zufari4/RadioChat/Docs/Used pins.txt

Pin number = GPIO_N - where N is pin number

[ Flash ]

miso = 19
mosi = 23
sck  = 18
cs   = 5

[ Display ]

RS  = 2
R_W = 15
E   = 4
BLA = 17

[ Led ]

ON = 21

[ Buzzier ]

IO = 22

[ Keyboard ]

SH_LD = 16
QH    = 13
CLK   = 14

[ Radio ]

AUX = 32
M0  = 27
M1  = 26
RX  = 25
TX  = 33

[Battery]

ADC = 35
