zufari4/RadioChat/Docs/esp32-devkitC-v4-pinout.png

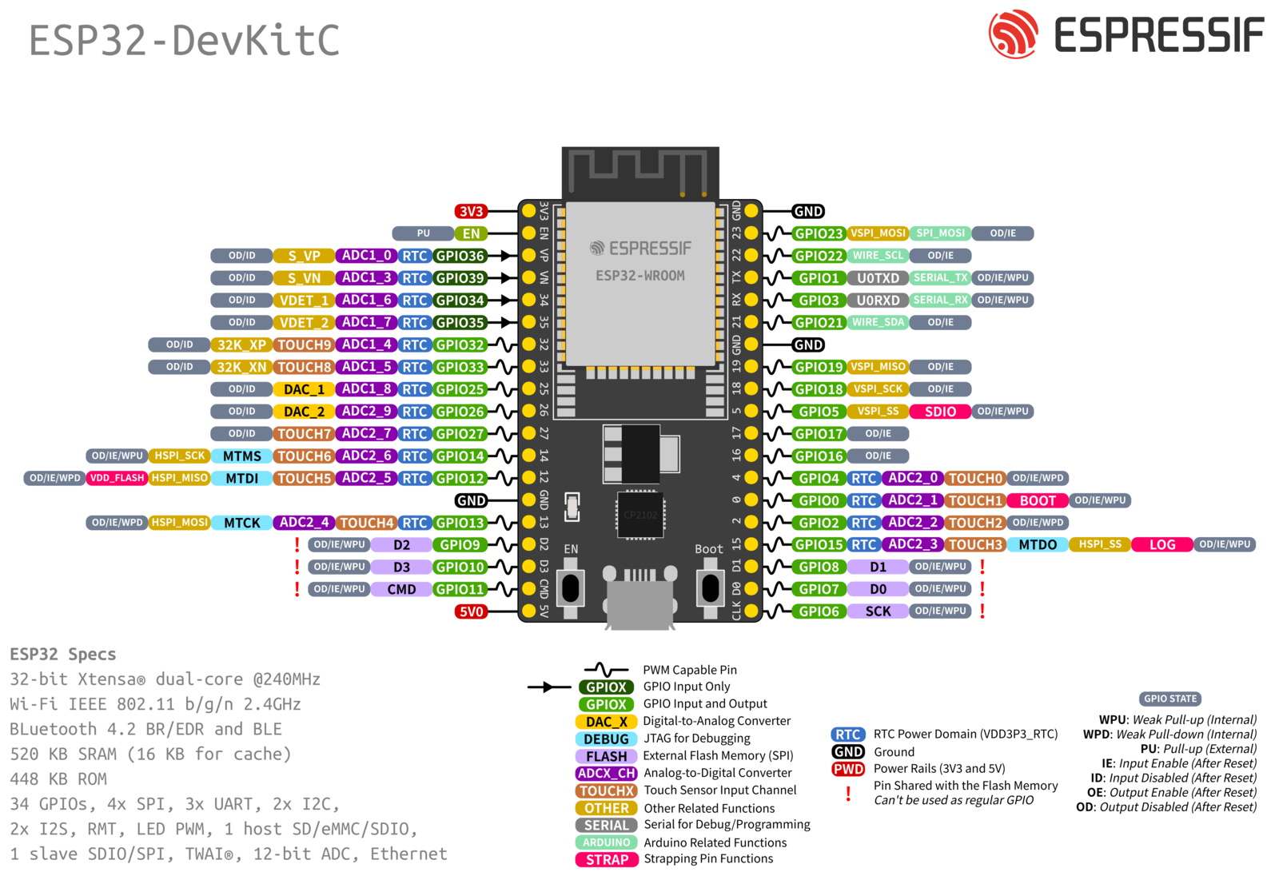
Docs/esp32-devkitC-v4-pinout.png
