zufari4/RadioChat/Docs/main plate lut.pdf

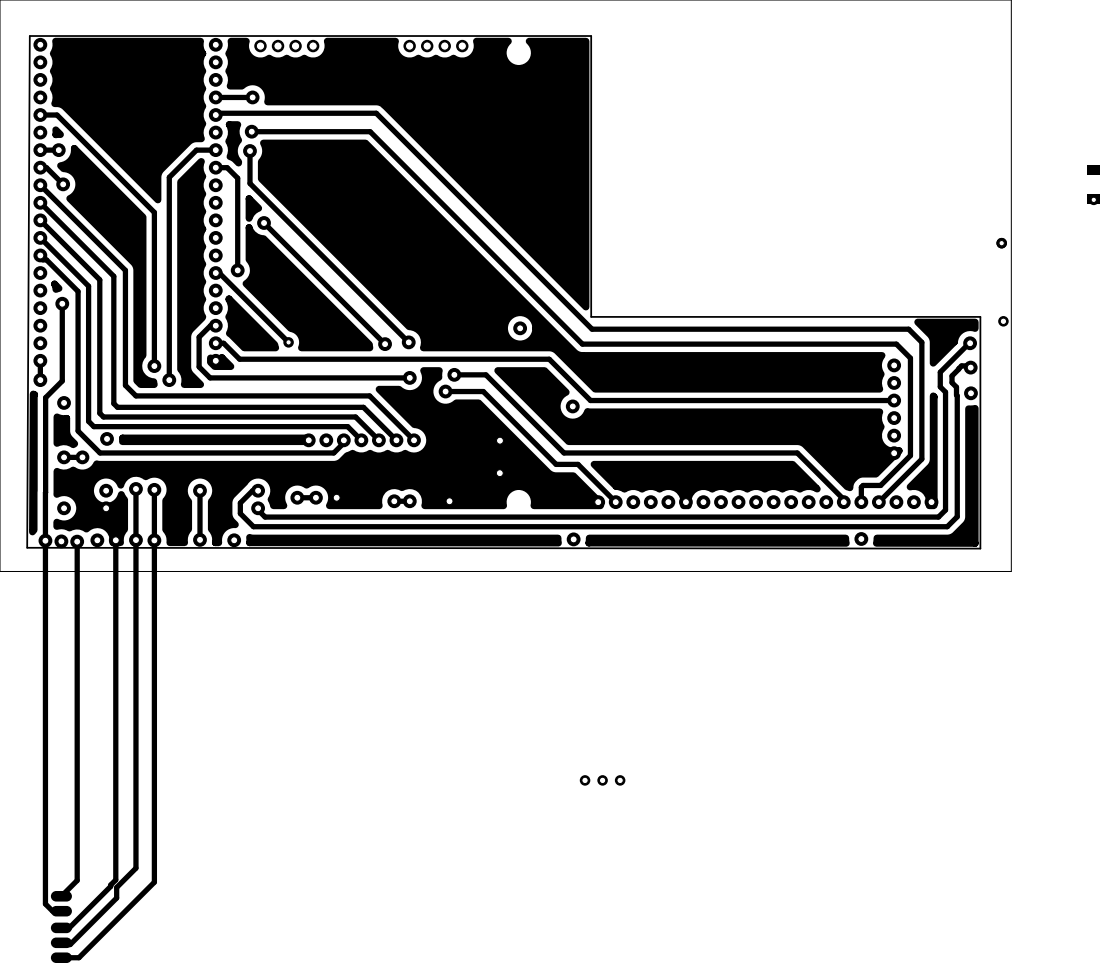
[picture p3: page 1]

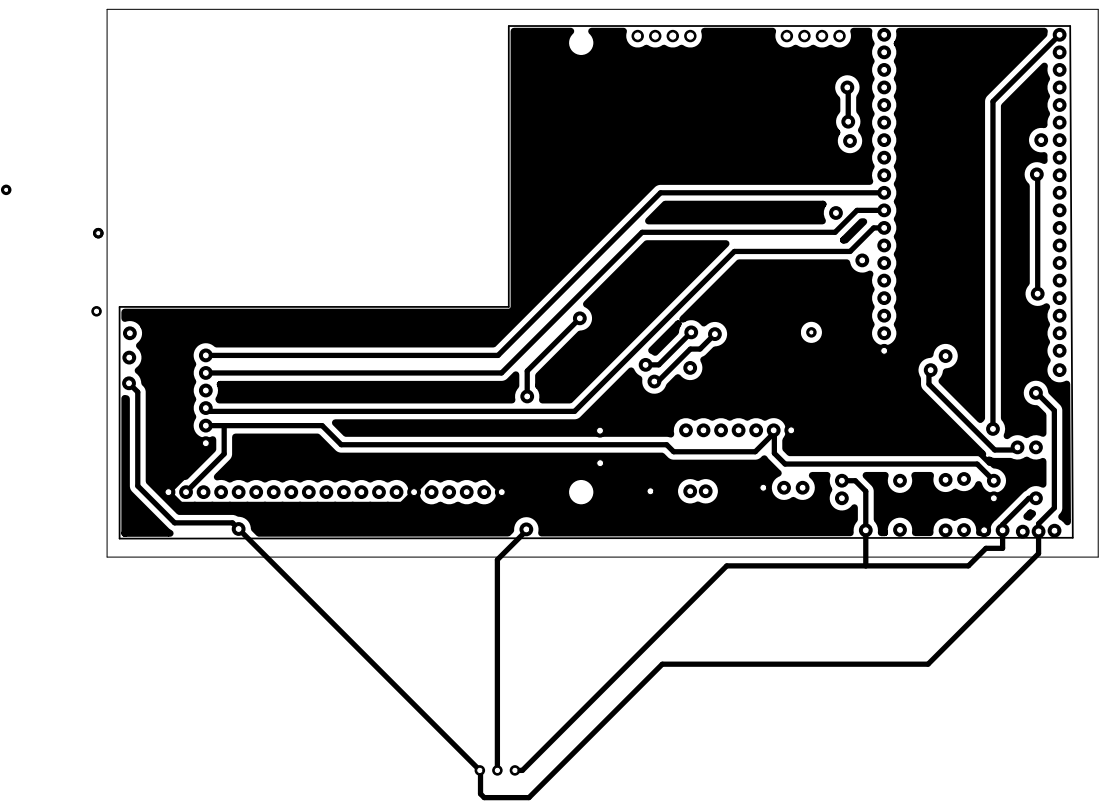
[picture p4: page 2]
