zufari4/RadioChat/RadioChat/src/Radio/Radio.cpp

#include "Radio.h"
#include "../Logger/Logger.h"
#include "../Settings/Settings.h"
#include "RadioCommand.h"
#include <HardwareSerial.h>
#include <Arduino.h>
#include <stdint.h>
#include <limits>

Radio::Radio()
    : currentMode_(Lora::Mode::Undefined)
    , isInit_(false)
    , newMessageID_(0)
{
}

Radio::~Radio()
{

}

void Radio::init(Settings& settings, OnNewMessageCallback onNewMessage, OnMessageDeliveryCallback onMessageDelivered, OnPingDone onPingDone)
{
    LOG_INF("-- Initialize radio module --");
    loadSettings(settings);
    onNewMessage_ = onNewMessage;
    onMessageDelivered_ = onMessageDelivered;
    onPingDone_ = onPingDone;
  
    LOG_INF("Setup pins");
    pinMode(settings_.pins.AUX, INPUT);
	pinMode(settings_.pins.M0, OUTPUT);
    pinMode(settings_.pins.M1, OUTPUT);

    LOG_INF("Wait device is ready");
    if (!waitReady()) {
        return;
    }
    
    LOG_INF("Init UART");
    Serial2.setTimeout(settings_.uart.timeoutMs);
    Serial2.begin(settings_.uart.baudrate, settings_.uart.parity, settings_.pins.TX, settings_.pins.RX);
    while (!Serial2) { } //wait for serial port to connect
    
    Lora::Configuration cfg;
    if (!getConfiguration(cfg)) {
        LOG_ERR("Can't get radio configuration");
        return;
    }
    traceConfig(cfg);
    if (settings_.channel != cfg.chan) {
        if (!setChannel(cfg.chan)) {
            return;
        }
    }
    if (settings_.selfAddress != Lora::get_address(cfg)) {
        if (!setAddress(settings_.selfAddress)) {
            return;
        }
    }
    if (settings_.subPacketSize != cfg.option.subPacketSetting) {
        if (!setSubPacketSize(settings_.subPacketSize)) {
            return;
        }
    }
    if (settings_.airRate != cfg.speed.airDataRate) {
        if (!setAirDataRate(settings_.airRate)) {
            return;
        }
    }
    LOG_INF("Max message size %u", getMaxMessageSize());
    isInit_ = setMode(Lora::Mode::Transfer);
}

bool Radio::isInit() const
{
    return isInit_;
}

bool Radio::setChannel(uint8_t channel)
{
    LOG_INF("Set channel %u", channel);
    auto setter = [channel](Lora::Configuration& cfg) 
    {
        cfg.chan = channel;
    };
    if (!setConfiguration(setter)) {
        LOG_ERR("Can't set channel");
        return false;
    } 
    return true;
}

bool Radio::setAddress(uint16_t addr)
{
    LOG_INF("Set address %u", addr);
    auto setter = [addr](Lora::Configuration& cfg) 
    {
        cfg.addh = (addr>>8) & 0xff;
        cfg.addl = addr & 0xff;
    };
    if (!setConfiguration(setter)) {
        LOG_ERR("Can't set address");
        return false;
    } 
    return true;
}

bool Radio::setSubPacketSize(uint8_t size)
{
    LOG_INF("Set sub packet size %s", Lora::sub_pack_str(size));
    auto setter = [size](Lora::Configuration& cfg)
        {
            cfg.option.subPacketSetting = size;
        };
    if (!setConfiguration(setter)) {
        LOG_ERR("Can't sub packet size");
        return false;
    }
    return true;
}

bool Radio::setAirDataRate(uint8_t rate)
{
    LOG_INF("Set air data rate %s", Lora::air_rate_str(rate));
    auto setter = [rate](Lora::Configuration& cfg)
        {
            cfg.speed.airDataRate = rate;
        };
    if (!setConfiguration(setter)) {
        LOG_ERR("Can't set air data rate");
        return false;
    }
    return true;
}

bool Radio::setConfiguration(std::function<void(Lora::Configuration& cfg)> setter)
{
    Lora::Mode prevMode = currentMode_;
    bool res = false;

    do {
        std::lock_guard guard(mutexSerial_);

        if (!setMode(Lora::Mode::Configuration)) {
            break;
        }
        Lora::Configuration cfg;
        if (!getConfiguration(cfg)) {
            break;
        }

        cfg.command = Lora::PROGRAM_COMMAND::WRITE_CFG_PWR_DWN_SAVE;
        cfg.address = Lora::REGISTER_ADDRESS::REG_ADDRESS_CFG;
        cfg.length  = Lora::PACKET_LENGHT::PL_CONFIGURATION;

        setter(cfg);

        if (!writeData(&cfg, sizeof(Lora::Configuration))) {
            break;
        }
        if (!readData(&cfg, sizeof(Lora::Configuration))) {
            break;
        }
        if (Lora::PROGRAM_COMMAND::WRONG_FORMAT == cfg.command) {
		    LOG_ERR("Wrong format");
            break;
        }
        if (Lora::PROGRAM_COMMAND::RETURNED_COMMAND != cfg.command || 
            Lora::REGISTER_ADDRESS::REG_ADDRESS_CFG != cfg.address || 
            Lora::PACKET_LENGHT::PL_CONFIGURATION   != cfg.length) {
            LOG_ERR("Head is not recognized");
		    break;
	    }
        res = true;
    } while (false);

    res = setMode(prevMode) && res;
    return res;
}

bool Radio::getConfiguration(Lora::Configuration& out)
{
    LOG_DBG("Get configuration");
    std::lock_guard guard(mutexSerial_);

    Lora::Mode prevMode = currentMode_;
    bool res = false;

    do {
        if (!setMode(Lora::Mode::Configuration)) {
            break;
        }
        if (!writeProgramCommand(Lora::PROGRAM_COMMAND::READ_CONFIGURATION,
                                 Lora::REGISTER_ADDRESS::REG_ADDRESS_CFG, 
                                 Lora::PACKET_LENGHT::PL_CONFIGURATION)) {
            break;
        }
        Lora::Configuration cfg;
        if (!readData(&cfg, sizeof(cfg))) {
            break;
        }
        if (Lora::PROGRAM_COMMAND::WRONG_FORMAT == cfg.command) {
		    LOG_ERR("Wrong format");
            break;
        }
        if (Lora::PROGRAM_COMMAND::RETURNED_COMMAND != cfg.command || 
            Lora::REGISTER_ADDRESS::REG_ADDRESS_CFG != cfg.address || 
            Lora::PACKET_LENGHT::PL_CONFIGURATION   != cfg.length) {
            LOG_ERR("Head is not recognized");
		    break;
	    }
        out = cfg;
        res = true;
	} while(false);

    return setMode(prevMode) && res;
}

bool Radio::isReady()
{
    return digitalRead(settings_.pins.AUX) == HIGH;
}

bool Radio::waitReady()
{
    const unsigned long timeout = millis() + settings_.uart.timeoutMs;
    while (!isReady() && millis() < timeout) {
        yield();
    }
    if (millis() >= timeout) {
        LOG_ERR("Timeout of wait AUX ready");
        return false;
    }
    else {
        delay(20); // per data sheet control after aux goes high is 2ms so delay for at least that long
    }

    return true;
}

void Radio::check()
{
    if (!isInit_) {
        return;
    }
    std::lock_guard guard(mutexSerial_);

    if (!Serial2.available()) {
        return;
    }

    uint8_t sender_addh;
    uint8_t sender_addl;
    RadioCommand cmd;
    uint8_t isBroadcast = 0;

    if (!readData(&sender_addh, 1, false)) {
        LOG_ERR("Radio: Can't read sender_addh");
        return;
    }
    if (!readData(&sender_addl, 1, false)) {
        LOG_ERR("Radio: Can't read sender_addl");
        return;
    }

    uint16_t sender = Lora::get_address(sender_addh, sender_addl);
    LOG_DBG("Radio: Sender address %u", sender);

    if (!readData(&isBroadcast, 1, false)) {
        LOG_ERR("Radio: Can't read broadcast flag");
        return;
    }
    LOG_DBG("Radio: broadcast flag: %u", isBroadcast);

    if (!readData(&cmd, 1, false)) {
        LOG_ERR("Radio: Can't read cmd");
        return;
    }
    LOG_DBG("Radio: command %s", commandStr(cmd));

    switch (cmd)
    {
    case RadioCommand::MessageNew: {
        std::string text;
        uint8_t msgID = receiveText(text);
        if (msgID > 0) {
            if (isBroadcast == 0) {
                sendDelivered(sender, msgID);
            }
            if (onNewMessage_) {
                uint16_t destAddress = isBroadcast == 1 ? BROADCAST_ADDRESS : settings_.selfAddress;
                onNewMessage_(sender, destAddress, msgID, text);
            }
        }
        break;
    }
    case RadioCommand::MessageDelivered: {
        uint8_t msgID;
        if (readData(&msgID, 1)) {
            LOG_INF("Radio: delivered %u", msgID);
            onMessageDelivered_(sender, msgID);
        }   
        break;
    }
    case RadioCommand::Ping: {
        sendPingDelivered(sender);
        break;
    }
    case RadioCommand::PingDelivered: {
        uint32_t startMillis;
        if (readData(&startMillis, 4)) {
            uint32_t delay = millis() - startMillis;
            LOG_INF("Radio: ping delivered from %u delay %u", sender, delay);
            onPingDone_(sender, delay);
        }
        break;
    }
    default: {
        LOG_ERR("Radio: Unknown command %u", (uint8_t)cmd);
        break;
    }
    }
}

bool Radio::setMode(Lora::Mode mode)
{
    if (mode == Lora::Mode::Undefined) {
        return true;
    }
    if (currentMode_ == mode) {
        return true;
    }
    LOG_INF("Set radio mode: %s", radio_mode_str(mode));

    // data sheet claims module needs some extra time after mode setting (2ms)
	// most of my projects uses 10 ms, but 40ms is safer
    //delay(40);
    
    switch (mode)
    {
    case Lora::Mode::Transfer:
        digitalWrite(settings_.pins.M1, LOW);
        digitalWrite(settings_.pins.M0, LOW);
        break;
    case Lora::Mode::Configuration:
        digitalWrite(settings_.pins.M1, HIGH);
        digitalWrite(settings_.pins.M0, LOW);
        break;
    case Lora::Mode::WOR:
        digitalWrite(settings_.pins.M1, LOW);
        digitalWrite(settings_.pins.M0, HIGH);
        break;
    case Lora::Mode::Sleep:
        digitalWrite(settings_.pins.M1, HIGH);
        digitalWrite(settings_.pins.M0, HIGH);
        break;
    default:
        LOG_ERR("Unknown mode %u", (uint8_t)mode);
        return false;
    }

	// data sheet says 2ms later control is returned, let's give just a bit more time
	// these modules can take time to activate pins
	delay(40);
	bool res = waitReady();
    if (!res) {
        LOG_ERR("Can't wait status of set mode");
    }

    currentMode_ = mode;
    return res;
}

bool Radio::writeProgramCommand(Lora::PROGRAM_COMMAND cmd, Lora::REGISTER_ADDRESS addr, Lora::PACKET_LENGHT pl)
{
    LOG_DBG("Write command"); 
	uint8_t data[3] = {(uint8_t)cmd, (uint8_t)addr, (uint8_t)pl};
    if (!writeData(data, 3)) {
        LOG_ERR("Can't write command");
        return false;
    }
    return true;
}

bool Radio::writeData(void* data, size_t dataSize)
{
    uint8_t* ptr = (uint8_t*)data;
    traceTraffic("-->", ptr, dataSize);
	size_t size = Serial2.write(ptr, dataSize);
    //delay(50);  //need ti check
    if (size != dataSize) {
        LOG_ERR("Wrong size of write data: %zd", size);
        return false;
    }
	else if (size == dataSize) {
        if (!waitReady()) {
            return false;
        }
        //while (Serial2.available()) {
        //    Serial2.read();
        //}
    }
    return true;
}

bool Radio::readData(void* out, size_t needSize, bool needWaitReady /*= true*/)
{
    size_t received = Serial2.readBytes((uint8_t*)out, needSize);

	if (received != needSize) {
		LOG_ERR("Wrong length of receive. Need %zd actual %zd", needSize, received);
        return false;
	}

	bool res = needWaitReady ? waitReady() : true;
    if (!res) {
        LOG_ERR("Can't wait status of read bytes");
    }
    return res;
}

void Radio::traceConfig(const Lora::Configuration& cfg) const
{
	LOG_DBG("HEAD: %02X %02X %02X", (uint8_t)cfg.command, (uint8_t)cfg.address, (uint8_t)cfg.length);
	LOG_DBG("AddH : %02X", cfg.addh);  
	LOG_DBG("AddL : %02X", cfg.addl);  
	LOG_DBG("NetID: %02X", cfg.netid); 
	LOG_DBG("Channel: %s", Lora::channel_str(cfg.chan).c_str());
	LOG_DBG("UART parity: %s", Lora::parity_str(cfg.speed.uartParity));
	LOG_DBG("UART baud rate: %s", Lora::bps_type_str(cfg.speed.uartBaudRate));
    LOG_DBG("Air data rate: %s", Lora::air_rate_str(cfg.speed.airDataRate));
    LOG_DBG("Subpacket size: %s", Lora::sub_pack_str(cfg.option.subPacketSetting));
    LOG_DBG("Transmission power: %s", Lora::transmission_power_str(cfg.option.transmissionPower));
    LOG_DBG("RSSI ambient noise: %s", Lora::rssi_noize_str(cfg.option.RSSIAmbientNoise));
    LOG_DBG("WOR period: %s", Lora::wor_period_str(cfg.transMode.WORPeriod));
    LOG_DBG("WOR control: %s", Lora::wor_control_str(cfg.transMode.WORTransceiverControl));
    LOG_DBG("LBT: %s", Lora::lbt_enable_str(cfg.transMode.enableLBT));
    LOG_DBG("RSSI: %s", Lora::rssi_enable_str(cfg.transMode.enableRSSI));
    LOG_DBG("Repeater mode: %s", Lora::repeater_enable_str(cfg.transMode.enableRepeater));
    LOG_DBG("Fixed mode: %s", Lora::fixed_transmiss_str(cfg.transMode.fixedTransmission));
}

void Radio::addHeader(std::vector<uint8_t>& out, uint16_t destAddr, RadioCommand command)
{
    out.push_back(Lora::get_addr_h(destAddr));
    out.push_back(Lora::get_addr_l(destAddr));
    out.push_back(settings_.channel);

    out.push_back(Lora::get_addr_h(settings_.selfAddress));
    out.push_back(Lora::get_addr_l(settings_.selfAddress));
    out.push_back(destAddr == BROADCAST_ADDRESS ? 1 : 0);
    out.push_back(static_cast<uint8_t>(command));
}

bool Radio::ping(uint16_t addr)
{
    std::lock_guard guard(mutexSerial_);

    if (!sendPing(addr)) {
        return false;
    }
    return true;
}

uint8_t Radio::sendText(const std::string& text, uint16_t destAddr /*= BROADCAST_ADDRESS*/)
{
    uint16_t textSize = static_cast<uint16_t>(text.size());
    LOG_INF("Send text '%s' to %u. Size %u", text.c_str(), destAddr, textSize);
    std::lock_guard guard(mutexSerial_);

    // 1: byte dest ADDH
    // 2: byte dest ADDL
    // 3: byte CHAN

    // 4: byte sender ADDH
    // 5: byte sender ADDL
    // 6: broadcast flag
    // 7: byte cmd

    // 8: byte msg_id
    // 9: byte msg_len
    // byte message[msg_len];
    std::vector<uint8_t> data;
    uint8_t  msgID = ++newMessageID_;

    {
        addHeader(data, destAddr, RadioCommand::MessageNew);

        uint16_t maxMsgSize = getMaxMessageSize();
        uint8_t msgSize = static_cast<uint8_t>(std::min(maxMsgSize, textSize));

        data.push_back(msgID);
        data.push_back(msgSize);
        data.insert(data.end(), text.begin(), text.begin() + msgSize);
    }

    bool res = writeData(data.data(), data.size());
    return res ? msgID : 0;
}

uint8_t Radio::receiveText(std::string& text)
{
    uint8_t msg_id;
    uint8_t msg_len;

    if (!readData(&msg_id, 1, false)) {
        LOG_ERR("Can't read msg_id");
        return 0;
    }
    LOG_DBG("Receive msg_id %u", msg_id);

    if (!readData(&msg_len, 1, false)) {
        LOG_ERR("Can't read msg_len. msg_id %u", msg_id);
        return 0;
    }

    LOG_DBG("Receive msg_len %u", msg_len);

    std::vector<uint8_t> data(msg_len + 1, '\0');        
    if (!readData(data.data(), msg_len, true)) {
        LOG_ERR("Can't read text message. msg_id %u", msg_id);
        return 0;
    }
    text.assign(data.begin(), data.end());
    LOG_INF("Receive '%s' msg_id %u size %u", text.c_str(), msg_id, msg_len);
    return msg_id;
}

void Radio::sendDelivered(uint16_t sender, uint8_t msgID)
{
    LOG_INF("Send status delivered msgID %u to %u ", msgID, sender);
    // byte dest ADDH
    // byte dest ADDL
    // byte CHAN

    // byte sender ADDH
    // byte sender ADDL
    // byte broadcast flag
    // byte cmd

    // byte msg_id

    std::vector<uint8_t> data;
    addHeader(data, sender, RadioCommand::MessageDelivered);
    data.push_back(msgID);

    if (!writeData(data.data(), data.size())) {
        LOG_ERR("Can't send delivered status");
    }
}

bool Radio::sendPing(uint16_t dest)
{
    LOG_INF("Send ping to %u", dest);
    // byte dest ADDH
    // byte dest ADDL
    // byte CHAN

    // byte sender ADDH
    // byte sender ADDL
    // byte broadcast flag
    // byte cmd
    // 4 bytes millis() start time

    std::vector<uint8_t> data;
    addHeader(data, dest, RadioCommand::Ping);

    std::vector<uint8_t> millisData(4);
    uint32_t millisValue = millis();
    memcpy(millisData.data(), &millisValue, sizeof(millisValue));

    data.insert(data.end(), millisData.begin(), millisData.end());

    if (!writeData(data.data(), data.size())) {
        LOG_ERR("Can't send ping");
        return false;
    }

    return true;
}

void Radio::sendPingDelivered(uint16_t sender)
{
    LOG_INF("Send ping delivered to %u", sender);
    // byte dest ADDH
    // byte dest ADDL
    // byte CHAN

    // byte sender ADDH
    // byte sender ADDL
    // byte isBroadcast // 0 - not broadcast, 1 - broadcast
    // byte cmd
    // 4 bytes millis() start time

    std::vector<uint8_t> data;
    addHeader(data, sender, RadioCommand::PingDelivered);

    if (!writeData(data.data(), data.size())) {
        LOG_ERR("Can't send ping delivered");
    }
}

void Radio::traceTraffic(const char* direction, uint8_t* data, size_t dataSize) const
{
    if (dataSize > 0) {
        if (Logger::instance().getLogLevel() == LogTraceLevel::Debug) {
            std::string str;
            char hex[4];
            for (size_t i = 0; i < dataSize; ++i) {
                if (i != 0 && i % 16 == 0) {
                    LOG_DBG("%s %s", direction, str.c_str());
                    str.clear();
                }
                sprintf(hex, "%02X ", data[i]);
                str += hex;
            }
            if (!str.empty()) {
                LOG_DBG("%s %s", direction, str.c_str());
            }
        }
    }
    else {
        LOG_DBG("%s NO_DATA!", direction);
    }
}

uint8_t Radio::getMaxMessageSize() const
{
    uint8_t subPacketSize;
    if (settings_.subPacketSize == static_cast<uint8_t>(Lora::SUB_PACKET_SETTING::e032)) {
        subPacketSize = 32;
    }
    else if (settings_.subPacketSize == static_cast<uint8_t>(Lora::SUB_PACKET_SETTING::e064)) {
        subPacketSize = 64;
    }
    else if (settings_.subPacketSize == static_cast<uint8_t>(Lora::SUB_PACKET_SETTING::e128)) {
        subPacketSize = 128;
    }
    else if (settings_.subPacketSize == static_cast<uint8_t>(Lora::SUB_PACKET_SETTING::e240)) {
        subPacketSize = 240;
    }
    else {
        LOG_ERR("Unknown sub packet size %u. Use 32", settings_.subPacketSize);
        subPacketSize = 32;
    }

    return subPacketSize - 9 /*header for text*/;
}

const RadioSettings& Radio::getSettings() const
{
    return settings_;
}

void Radio::loadSettings(Settings& settings)
{
    auto props = settings.radio();
    settings_.airRate = Settings::get_i(eRadioAirRate, props);
    settings_.channel = Settings::get_i(eRadioChannel, props);
    settings_.selfAddress = Settings::get_i(eRadioSelfAddress, props);
    settings_.subPacketSize = Settings::get_i(eRadioSubPacketSize, props);
    settings_.pins.RX = Settings::get_i(eRadioPinRX, props);
    settings_.pins.TX = Settings::get_i(eRadioPinTX, props);
    settings_.pins.AUX = Settings::get_i(eRadioPinAUX, props);
    settings_.pins.M0 = Settings::get_i(eRadioPinM0, props);
    settings_.pins.M1 = Settings::get_i(eRadioPinM1, props);
    settings_.uart.baudrate = Settings::get_i(eRadioUARTBaudrate, props);
    settings_.uart.timeoutMs = Settings::get_i(eRadioUARTTimeoutMs, props);
    settings_.uart.parity = Settings::get_i(eRadioUARTParity, props);
}
