zufari4/RadioChat/RadioChat/src/Radio/Radio.h

#pragma once

#include "RadioSettings.h"
#include "RadioCommand.h"
#include "Lora.h"
#include <functional>
#include <stdint.h>
#include <map>
#include <mutex>

class Settings;

class Radio
{
public:
    using OnNewMessageCallback = std::function<void(uint16_t sender, uint16_t dest, uint8_t msgID, const std::string& text)>;
    using OnMessageDeliveryCallback = std::function<void(uint16_t address, uint8_t msgID)>;
    using OnPingDone = std::function<void(uint16_t address, uint32_t delay)>;

    Radio();
    ~Radio();
    void init(Settings& settings, OnNewMessageCallback onNewMessage, OnMessageDeliveryCallback onMessageDelivered, OnPingDone onPingDone);
    void check();
    bool isInit() const;

    bool setChannel(uint8_t channel);
    bool setAddress(uint16_t addr);
    bool setSubPacketSize(uint8_t size);
    bool setAirDataRate(uint8_t rate);

    uint8_t sendText(const std::string& text, uint16_t address = BROADCAST_ADDRESS);
    bool ping(uint16_t addr);
    uint8_t getMaxMessageSize() const; // max size of text message in bytes
    const RadioSettings& getSettings() const;

private:
    bool setMode(Lora::Mode mode);
    bool waitReady();
    bool isReady();
    bool getConfiguration(Lora::Configuration& out);
    bool writeProgramCommand(Lora::PROGRAM_COMMAND cmd, Lora::REGISTER_ADDRESS addr, Lora::PACKET_LENGHT pl);
    bool readData(void* out, size_t needSize, bool needWaitReady = true);
    bool writeData(void* data, size_t dataSize);
    void traceConfig(const Lora::Configuration& cfg) const;
    bool setConfiguration(std::function<void(Lora::Configuration& cfg)> fn);
    uint8_t receiveText(std::string& text);
    void sendDelivered(uint16_t sender, uint8_t msgID);
    bool sendPing(uint16_t dest);
    void sendPingDelivered(uint16_t sender);
    void addHeader(std::vector<uint8_t>& out, uint16_t destAddr, RadioCommand command);
    void traceTraffic(const char* direction, uint8_t* data, size_t dataSize) const;
    void loadSettings(Settings& settings);

    RadioSettings settings_;
    Lora::Mode currentMode_;
    bool isInit_;
    uint8_t newMessageID_;
    OnNewMessageCallback onNewMessage_;
    OnMessageDeliveryCallback onMessageDelivered_;
    OnPingDone onPingDone_;
    std::mutex mutexSerial_;
};
