zufari4/RadioChat/RadioChat/src/RadioChat.h

#pragma once

#include <stdint.h>
#include <string>
#include <thread>
#include <atomic>
#include <memory>
#include "UI/UIPageType.h"
#include "UI/TypingMessageAction.h"
#include "QueueMessage/SafeQeue.h"
#include "Settings/Property.h"

class Flash;
class Settings;
class Esp;
class KeyHandler;
class Display;
class Radio;
class LedIndicator;
class UI;
class Sound;
class Battery;
class ContactsManager;
class QueueMessageBase;
class ChatManager;
enum class KeyCommand;

class RadioChat
{
public:
    RadioChat();
    ~RadioChat();
    void init();
    void loop();

private:
    using MessagePtr = std::unique_ptr<QueueMessageBase>;
    static void checkQueueThread(void* thisPtr);
    void runThreadCheckQueue();
    void checkQueue();
    void pushTypingChar(uint16_t code);
    void pushKeyboardCommand(KeyCommand cmd);
    void pushAcceptMessage(uint16_t sender, uint16_t dest, uint8_t msgID, const std::string& text);
    void pushDeliveryMessage(uint16_t address, uint8_t msgID);
    void pushPingDone(uint16_t address, uint32_t delay);
    void pushShowPage(UIPageType pageType);
    void pushShowPageTypingMessage(UIPageType parent, TypingMessageAction action, uint16_t address);
    void pushShowPagePropertyList(const PropertyMap& properties);
    void pushShowPageEditProperty(const Property& prop);
    void pushShowPageChatContact(uint16_t address);
    void pushShowPageContactActions(uint16_t address);
    void pushShowPagePing(uint16_t address);

    Settings*     settings_;
    Esp*          esp_;
    KeyHandler*   keyHandler_;
    Display*      display_;
    Radio*        radio_;
    LedIndicator* ledIndicator_;
    Sound*        sound_;
    Battery*      battery_;
    UI*           ui_;
    ContactsManager* contactsManager_;
    ChatManager* chatManager_;
    SafeQueue<MessagePtr> messageQueue_;
    std::thread   svcThread_;
};
