zufari4/RadioChat/RadioChat/src/Settings/PropertySection.h

#pragma once

#include <string_view>

enum class PropertySection
{
    None,
    Log,
    Esp,
    Keyboard,
    Display,
    Battery,
    Contacts,
    Flash,
    Led,
    Radio,
    Sound,
    UI,
    Chat
};

std::string_view propSectionToStr(PropertySection section);
