zufari4/RadioChat/RadioChat/LoggerSettings.h

#pragma once

#include <stdint.h>
#include <string>
#include "LogTraceLevel.h"
#include "Configuration.h"

struct LoggerSettings
{
#if DEBUG_MODE == 1
    LogTraceLevel level = LogTraceLevel::Debug;
    bool logToSerial = true;
#else
    LogTraceLevel level = LogTraceLevel::Error;
    bool logToSerial = false;
#endif
    std::string logPath = "logs";
    uint8_t  maxCountLogs  = 10;
    uint8_t  maxCountLines = 2000;
    uint16_t serialBuadrate = 9600;
    uint16_t serialInitDelay = 1000;
    uint16_t maxMessageSize = 256;
};
