zufari4/RadioChat/(commit log)

2024-04-14 Page for typing new message
    [Configuration.h]
2024-04-14 Add carriage
2024-04-15 Add key down and key up Add Escape key
    [Configuration.h]
2024-04-15 Fix show start logging
    [Logger.h]
2024-04-19 Print lora configuration
2024-04-25 Add flash and led indicator
2024-04-25 Logger instance
    [Configuration.h]
2024-05-22 Change project structure
    [Configuration.h]
2024-05-22 Rename folder
    [Configuration.h]
2024-05-22 Fix build
    [Configuration.h]
2024-05-22 Init flash
    [Configuration.h]
2024-05-24 Load logger settings
    [Configuration.h]
2024-06-17 Load display settings
    [Configuration.h]
2024-06-17 HH SPI for display
    [Configuration.h]
2024-06-25 Keyboard in different thread
    [Configuration.h]
2024-06-28 Remove INH pin from keyboard
2024-07-03 Add battery voltage
2024-07-04 Add chat page
    [Configuration.h]
2025-04-24 Change pins for battery and display
    [Configuration.h]
2025-04-25 change pin for batt mesurment esp not boot if 12 pin on hi volt
2025-04-28 Fix crash in Check Queue thread Increase stack size
    [RadioChat.cpp, RadioChat.h, UI.cpp]
2025-04-29 Fix send long message
    [Configuration.h]
2025-05-13 Fix save settings to flash
    [Configuration.h]
2025-06-03 Refactor settings
    [Configuration.h]
2025-06-03 Fix work with lora uart
    [Settings.cpp]
2025-06-03 Implement edit property
    [Configuration.h]
2025-06-20 implement shared chat
    [Configuration.h]
